Mauricio-xx/IHP__TEST3283/release/v.1.0.0/ReleaseNote.md

# TEST3283 v.1.0.0

First release. `gds/TEST3283.gds.gz` is the filled GDS for submission (checksum in `gds/SHA256SUMS`),
generated by `TEST3283-main/layout/klayout/scripts/flow.sh` from the TEST9203 fixture and the ihp-sg13cmos5l
pycell at IHP-Open-PDK dev 7b41fd10. The sealring area label is `8.94663 sq mm` (the fixture said
`8.9e-06 sq mm`). The LVS netlist is `netlist/TEST3283.cdl`. DRC and LVS evidence for this GDS is in
`doc/Signoff.md`.
