Mauricio-xx/IHP__TEST3283/doc/tile_B1.png

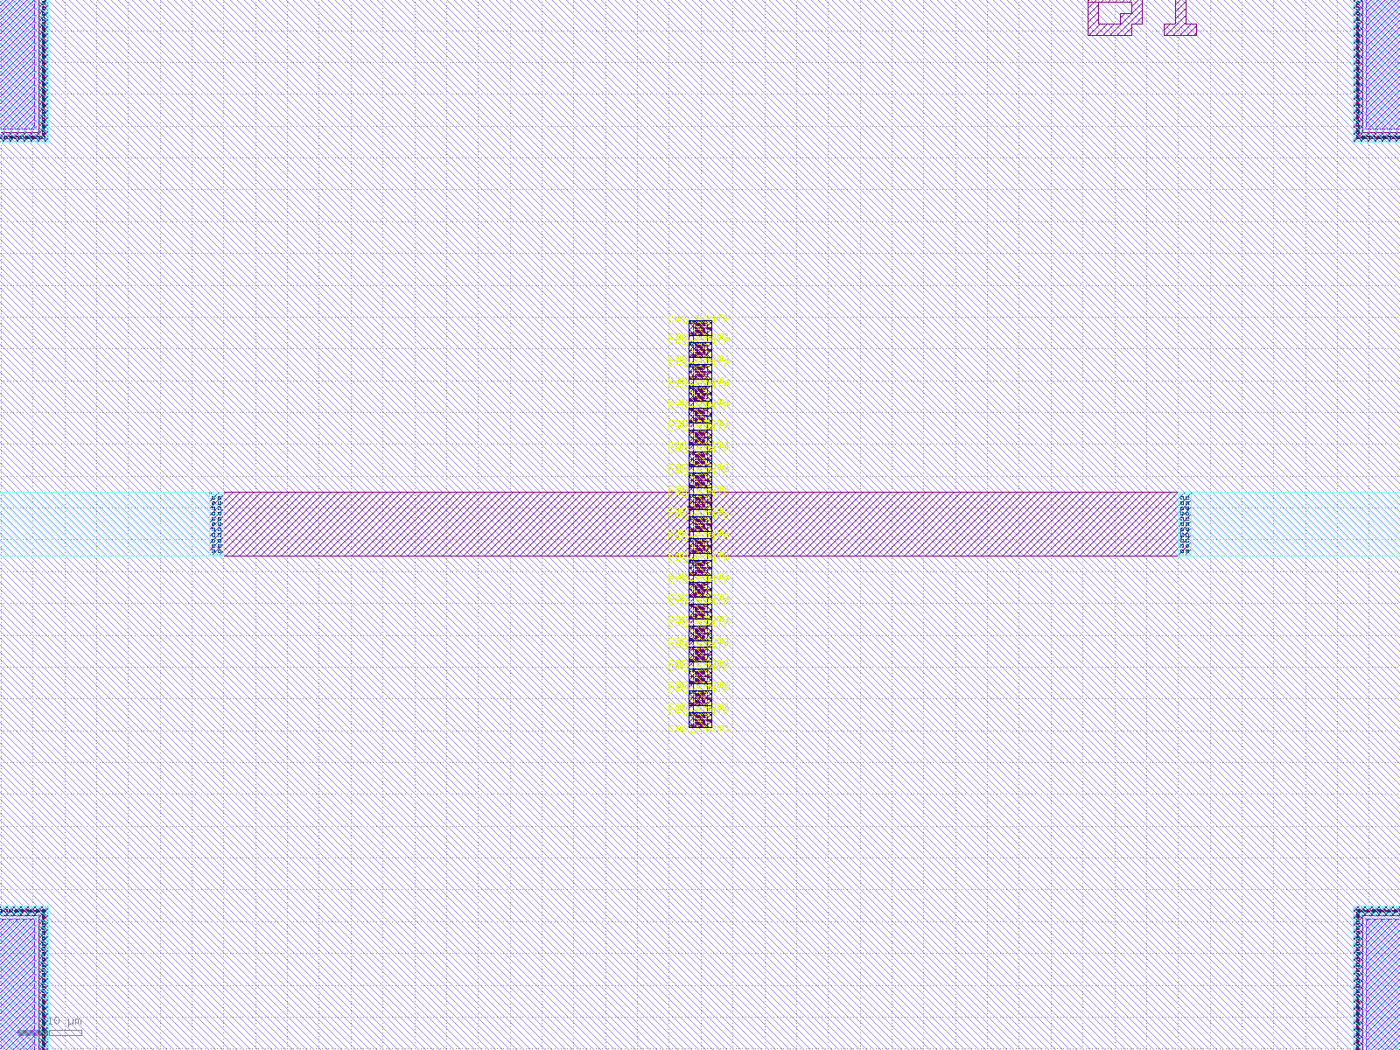
doc/tile_B1.png
