Mauricio-xx/IHP__TEST3283/doc/tile_B24.png

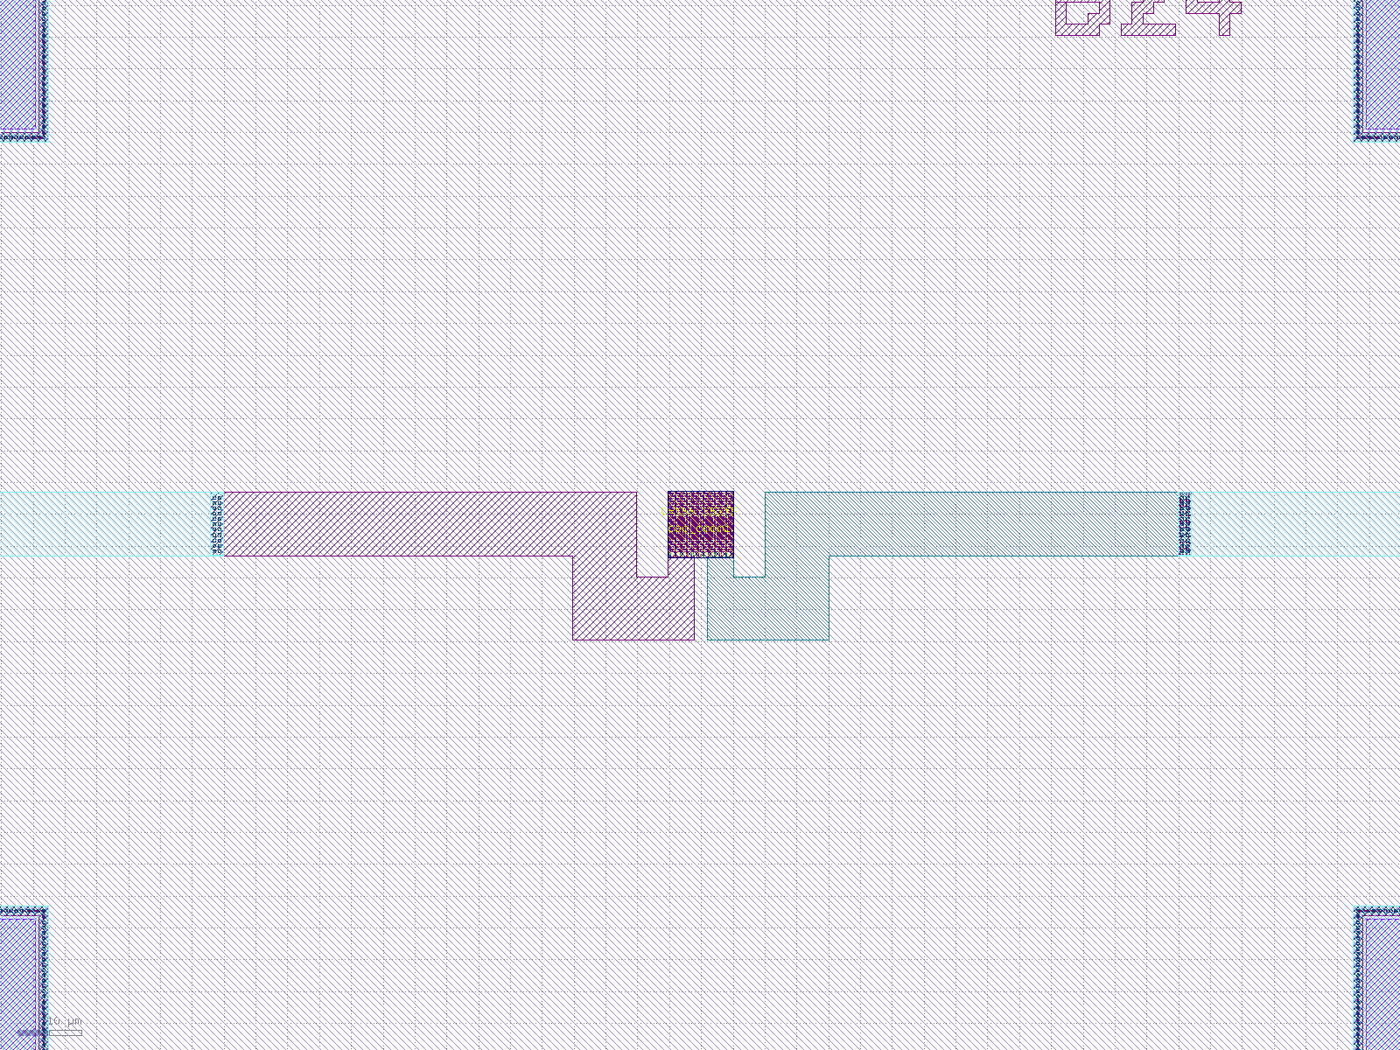
doc/tile_B24.png
