Mauricio-xx/IHP__TEST3283/TEST3283-main/layout/klayout/slots.csv

tile | row | col | momf_tile | momf_same_size | l_um | w_um | mmin | mmax | feed | mult | C_model_cell_fF | C_total_fF | group | rationale
B1 | 2 | 0 | A1 | A1 | 2.0 | 2.0 | 1 | 4 | double | 19 | 3.594 | 68.28 | N4_sq_dbl | area law + momf same-size comparison
B2 | 2 | 1 | A2 | A2 | 4.9 | 4.9 | 1 | 4 | double | 9 | 21.112 | 190.01 | N4_sq_dbl | area law + momf same-size comparison
B3 | 2 | 2 | A3 | A3 | 7.8 | 7.8 | 1 | 4 | double | 5 | 59.818 | 299.09 | N4_sq_dbl | area law + momf same-size comparison
B4 | 2 | 3 | A4 | A4 | 10.7 | 10.7 | 1 | 4 | double | 5 | 119.03 | 595.15 | N4_sq_dbl | area law + momf same-size comparison
B5 | 2 | 4 | A5 | A5 | 13.6 | 13.6 | 1 | 4 | double | 5 | 197.665 | 988.33 | N4_sq_dbl | area law + momf same-size comparison
B6 | 2 | 5 | A6 | A6 | 16.4 | 16.4 | 1 | 4 | double | 5 | 281.189 | 1405.95 | N4_sq_dbl | area law + momf same-size comparison
B7 | 2 | 6 | A7 | A8 | 22.2 | 22.2 | 1 | 4 | double | 5 | 511.798 | 2558.99 | N4_sq_dbl | area law + momf same-size comparison
B8 | 2 | 7 | A8 | A10 | 28.0 | 28.0 | 1 | 4 | double | 1 | 837.884 | 837.88 | N4_sq_dbl | area law + momf same-size comparison
B9 | 3 | 0 | A9 | A13 | 36.7 | 36.7 | 1 | 4 | double | 1 | 1442.251 | 1442.25 | N4_sq_dbl | area law + momf same-size comparison
B10 | 3 | 1 | A10 | A16 | 45.3 | 45.3 | 1 | 4 | double | 1 | 2166.27 | 2166.27 | N4_sq_dbl | area law + momf same-size comparison
B11 | 3 | 2 | A11 | A19 | 54.0 | 54.0 | 1 | 4 | double | 1 | 3137.335 | 3137.34 | N4_sq_dbl | area law + momf same-size comparison
B12 | 3 | 3 | A12 | A22 | 62.7 | 62.7 | 1 | 4 | double | 1 | 4230.633 | 4230.63 | N4_sq_dbl | area law + momf same-size comparison
B13 | 3 | 4 | A13 | A25 | 71.3 | 71.3 | 1 | 4 | double | 1 | 5486.907 | 5486.91 | N4_sq_dbl | area law + momf same-size comparison
B14 | 3 | 5 | A14 | A28 | 80.0 | 80.0 | 1 | 4 | double | 1 | 6901.948 | 6901.95 | N4_sq_dbl | area law + momf same-size comparison
B15 | 3 | 6 | A15 |  | 2.0 | 80.0 | 1 | 4 | double | 1 | 157.153 | 157.15 | N4_lsweep_dbl | fixed w=80, C vs l intercept -> feed + width-edge
B16 | 3 | 7 | A16 |  | 5.0 | 80.0 | 1 | 4 | double | 1 | 374.727 | 374.73 | N4_lsweep_dbl | fixed w=80, C vs l intercept -> feed + width-edge
B17 | 4 | 0 | A17 |  | 10.0 | 80.0 | 1 | 4 | double | 1 | 809.875 | 809.88 | N4_lsweep_dbl | fixed w=80, C vs l intercept -> feed + width-edge
B18 | 4 | 1 | A18 |  | 20.0 | 80.0 | 1 | 4 | double | 1 | 1680.171 | 1680.17 | N4_lsweep_dbl | fixed w=80, C vs l intercept -> feed + width-edge
B19 | 4 | 2 | A19 |  | 40.0 | 80.0 | 1 | 4 | double | 1 | 3420.764 | 3420.76 | N4_lsweep_dbl | fixed w=80, C vs l intercept -> feed + width-edge
B20 | 4 | 3 | A20 |  | 80.0 | 2.0 | 1 | 4 | double | 1 | 155.162 | 155.16 | N4_wsweep_dbl | fixed l=80, C vs w intercept -> finger-end/length-edge
B21 | 4 | 4 | A21 |  | 80.0 | 5.0 | 1 | 4 | double | 1 | 387.81 | 387.81 | N4_wsweep_dbl | fixed l=80, C vs w intercept -> finger-end/length-edge
B22 | 4 | 5 | A22 |  | 80.0 | 10.0 | 1 | 4 | double | 1 | 853.106 | 853.11 | N4_wsweep_dbl | fixed l=80, C vs w intercept -> finger-end/length-edge
B23 | 4 | 6 | A23 |  | 80.0 | 20.0 | 1 | 4 | double | 1 | 1706.148 | 1706.15 | N4_wsweep_dbl | fixed l=80, C vs w intercept -> finger-end/length-edge
B24 | 4 | 7 | A24 |  | 10.0 | 10.0 | 1 | 4 | same | 1 | 100.352 | 100.35 | N4_same | single-side feed on via-fixed geometry (unvalidated); ny odd
B25 | 5 | 0 | A25 |  | 20.5 | 20.5 | 1 | 4 | same | 1 | 453.302 | 453.3 | N4_same | single-side feed on via-fixed geometry (unvalidated); ny odd
B26 | 5 | 1 | A26 |  | 44.0 | 44.0 | 1 | 4 | same | 1 | 2083.571 | 2083.57 | N4_same | single-side feed on via-fixed geometry (unvalidated); ny odd
B27 | 5 | 2 | A27 |  | 80.0 | 80.0 | 1 | 4 | same | 1 | 6902.876 | 6902.88 | N4_same | single-side feed on via-fixed geometry (unvalidated); ny odd
B28 | 5 | 3 | A28 |  | 2.0 | 80.0 | 1 | 4 | same | 1 | 158.081 | 158.08 | N4_same | single-side feed on via-fixed geometry (unvalidated); ny odd
B29 | 5 | 4 | A29 |  | 22.2 | 22.2 | 3 | 4 | double | 1 | 259.887 | 259.89 | N2_M3M4_dbl | N2 extrapolated density 0.55 (largest EM deviation)
B30 | 5 | 5 | A30 |  | 80.0 | 80.0 | 3 | 4 | double | 1 | 3488.631 | 3488.63 | N2_M3M4_dbl | N2 extrapolated density 0.55 (largest EM deviation)
B31 | 5 | 6 | A31 |  | 2.0 | 80.0 | 3 | 4 | double | 1 | 85.294 | 85.29 | N2_M3M4_dbl | N2 edge/feed intercept
B32 | 5 | 7 | A32 |  | 80.0 | 80.0 | 3 | 4 | same | 1 | 3489.558 | 3489.56 | N2_M3M4_same | N2 same: 2-metal window, VA says ~3% low feed
B34 | 0 | 2 | A34 |  | 10.7 | 10.7 | 1 | 3 | double | 1 | 89.964 | 89.96 | N3_M1M3_dbl | N3 area law over size (momf had only 65.6-80)
B35 | 0 | 3 | A35 |  | 22.2 | 22.2 | 1 | 3 | double | 1 | 385.843 | 385.84 | N3_M1M3_dbl | N3 area law over size (momf had only 65.6-80)
B36 | 0 | 4 | A36 |  | 45.3 | 45.3 | 1 | 3 | double | 1 | 1631.363 | 1631.36 | N3_M1M3_dbl | N3 area law over size (momf had only 65.6-80)
B37 | 0 | 5 | A37 |  | 80.0 | 80.0 | 1 | 3 | double | 1 | 5195.289 | 5195.29 | N3_M1M3_dbl | N3 area law over size (momf had only 65.6-80)
B38 | 0 | 6 | A38 |  | 2.0 | 80.0 | 1 | 3 | double | 1 | 121.223 | 121.22 | N3_M1M3_dbl | N3 edge/feed intercept
B39 | 0 | 7 | A39 |  | 80.0 | 80.0 | 1 | 3 | same | 1 | 5196.217 | 5196.22 | N3_M1M3_same | N3 single-side feed, layer window check
B40 | 1 | 2 | A40 |  | 10.7 | 10.7 | 2 | 4 | double | 1 | 89.964 | 89.96 | N3_M2M4_dbl | N3 area law over size (momf had only 65.6-80)
B41 | 1 | 3 | A41 |  | 22.2 | 22.2 | 2 | 4 | double | 1 | 385.843 | 385.84 | N3_M2M4_dbl | N3 area law over size (momf had only 65.6-80)
B42 | 1 | 4 | A42 |  | 45.3 | 45.3 | 2 | 4 | double | 1 | 1631.363 | 1631.36 | N3_M2M4_dbl | N3 area law over size (momf had only 65.6-80)
B43 | 1 | 5 | A43 |  | 80.0 | 80.0 | 2 | 4 | double | 1 | 5195.289 | 5195.29 | N3_M2M4_dbl | N3 area law over size (momf had only 65.6-80)
B44 | 1 | 6 | A44 |  | 2.0 | 80.0 | 2 | 4 | double | 1 | 121.223 | 121.22 | N3_M2M4_dbl | N3 edge/feed intercept
B45 | 1 | 7 | A45 |  | 80.0 | 80.0 | 2 | 4 | same | 1 | 5196.217 | 5196.22 | N3_M2M4_same | N3 single-side feed, layer window check
