Mauricio-xx/IHP__TEST3283/TEST3283-main/testbenches/em/README.md

# EM bench

Work in progress in a separate repository (Palace electrostatic and full-wave, ihp-sg13cmos5l stackup), to
be merged here. It will hold one directory per simulated case with its inputs, command, logs and provenance,
and a results table per tile with the EM value, the PDK model value, the lead correction and an empty
measured column.
