Mauricio-xx/IHP__TEST3283/(commit log)

2026-10-29 Assemble cap_cmomi twin of TEST9203
    Cuts the cap_cmomf DUTs out of the TEST9203 tiles, drops cap_cmomi cells from
    the sg13cmos5l dev pycell and routes them to the existing M4 landing patches.
    Includes per-tile connectivity and fixture XOR checks.
    [slots.csv]
2026-10-29 Draw tile labels with an on-grid bitmap font, add serial flow script
    The TextGenerator glyphs left off-grid and non-45 degree edges on Metal4,
    caught by the full DRC deck. Labels are now 5x7 Manhattan glyphs on the
    5 nm grid. flow.sh runs build, checks, fill and both DRC decks in order.
2026-10-29 Lay out the repo like TEST9203 and add docs, release and measurement guide
    Generator moves to TEST3283-main/layout/klayout with the TEST9203 nofill
    reference it is built from. flow.sh now holds the shared heavy-job lock,
    checks the nofill GDS too and writes the release (filled GDS, as for
    TEST9203). README, Datasheet and Specification tables come from slots.csv.
    [slots.csv]
2026-10-29 Turn A33 into a lead short (LS) and generate docs from templates
    A33 was a second copy of OP. It is now the DUT fixture with a 10 um Metal4
    bar from patch to patch, so the series R and L of the landing patches and
    leads (inside the open-short reference plane) can be measured on every die.
    check_conn expects one signal net for LS, separate from ground.
    README.md and doc/Datasheet.md are now rendered by doc_tables.py from
    doc_templates/ and slots.csv. In c89695b the top README was never written
    and the Datasheet table came out empty: the generating shell used GROUPS,
    which is a bash builtin, and the failed assignment broke the && chain.
    Measurement guide and spec describe LS and the ESR/Q ex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
2026-10-29 Cap BLAS and OpenMP threads to one in the KLayout environment
2026-10-30 Add fill clearance check to the flow
    check_fill.py diffs the filled GDS against the nofill one and measures the
    gap from every device and calibration core to the nearest fill shape. On
    the current release all 47 cores pass, the closest fill is 5.0 um away.
2026-10-30 Document the same-feed MINUS tap, add a lead table, gate the flow
    Pre-tapeout audit findings. In the same-feed tiles the right lead lands on
    one MINUS finger row, and the rows only join at the stacked left pad, so
    the full row is in series with the device (about 9 ohm for B27, 17 for
    B32). The layout stays as it is: C is unaffected at low frequency, and a
    route around the device would add coupling to the C these tiles are for.
    README, Datasheet and the measurement guide now say so and keep these
    tiles out of R/Q/SRF comparisons.
    lead_table.py measures every lead and the tap row on the nofill GDS and
    writes leads.csv (tracked), which the measurement guide needed but only
    had in a gitignored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
    [leads.csv, slots.csv]
2026-10-30 Turn the same-feed cells and feed both halves of the stacked pad
    The same-feed MINUS lead used to land on one finger row, which put the
    full row (about 9 ohm on B27) in series with the device. The cells are
    now rotated R90 so the stacked pad runs along the bottom: PLUS contacts
    its left half on mmax, MINUS its right half on mmax-1, and each lead
    runs down and up a riser 5 um beside the cell to its landing. No lead
    crosses or encloses the device and the two contacts do not overlap.
    Flow clean: conn 45/0, fixture XOR clean, fill clearance 47/0, min and
    full DRC clean on the filled GDS. Release GDS replaced (FORCE=1).
    lead_table.py measures the new leads; docs and images updated.
    [leads.csv]
2026-10-30 Feed same-feed pads through short centre tabs
    Contacting the full pad halves added about 3.5 fF of PLUS-MINUS fringe on
    the small tiles. Each net now touches the pad with a 5 um tab near its
    centre, 2 um apart, and the lead bars run 3 um below the pad. Release,
    leads.csv, docs and renders regenerated.
    [leads.csv]
2026-10-30 Note the B24 tab clip, fix the spread-R comment
    On B24 the 5 um tab is clipped to the pad end (4.1 um), so its contact is
    unchanged from the half-pad version. Centre feed spread R is a bit above
    a full-half contact, not equal. For the record, the fringe cut in 4c77c07
    is on the L=80 tiles: facing edge 77.6 -> 10 um, about 6.9 -> 0.9 fF
    counting both pad edges (the 3.5 fF there counted one).
2026-10-30 Correct the sealring area label and stop declaring missing release paths
    The fixture text called 8.95 mm^2 "8.9e-06 sq mm". The build now rewrites that line from the sealring bbox, and the fixture check allows only that change. info.json no longer points at a netlist or a doc directory that are not in the tree.
2026-10-30 Derive DRC.md from the logs and tighten the fixture text check
    release.sh wrote 'No DRC violations' and precheck_drc as fixed text and
    copied whatever logs sat in build/. It now refuses to release unless both
    logs are newer than the GDS, name it as their design, pass, show the
    expected 'Minimum DRC enabled' value and come with an empty database, and
    DRC.md quotes those log lines. The invocation is --min_drc, as flow.sh
    passes it (alias of --minimum_drc).
    check_fixture.py accepted any area value and a deleted or moved label.
    Each changed fixture text must now pair with its rewrite at the same
    position: the area recomputed from the size line, the size matching the
    top bbox, and a 40-hex PDK v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
2026-10-30 Add an LVS netlist and run LVS on the release GDS
    lvs_netlist.py writes one cap_cmomi per placed cell from slots.csv (90
    instances in 44 tiles). The cmos5l deck matches the filled GDS against it,
    flat, with --ignore_top_ports_mismatch: every tile labels its pads c1/c2,
    so top-level port names repeat; without the option the only differences
    are those 88 names. Mutation runs: dropping a device or one array copy,
    adding one, or moving a terminal to another tile fails; a wrong metal
    band passes, as the deck documents.
    flow.sh runs LVS after DRC and gates the release on it. release.sh checks
    that the LVS log belongs to this GDS and netlist, publishes the netlist,
    and writes Signoff.md (DRC and L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
